OffshoreX/glance_AR_glasses/BOM.md

# Glance (AR Glasses Electronics) – bill of materials

<!-- Generated by Half Life from project cmuw1p55h04n901osjbinddlr. Edits here are overwritten on the next sync. -->
<!-- Generated: 2026-10-11T22:45:20.624Z -->

> [!NOTE]
> This parts list is mirrored from [Half Life](https://halflife.hackclub.com). Editing it here will not change the platform's copy, and the next sync overwrites this file.

| Week | Tier | Parts funding |
| --- | --- | --- |
| Week 1 | Tier 1 | $30.00 |

| Part | What it's for | Qty | Unit | Total | Vendor |
| --- | --- | --- | --- | --- | --- |
| [ESP32-S3-WROOM-1-N16R8 Wi-Fi/BLE module](https://www.lcsc.com/product-detail/C2913202.html) | — | 1 | $5.20 | $5.20 | [LCSC](https://www.lcsc.com/product-detail/C2913202.html) |
| [IR333-A 940nm IR LED 5mm (eye module)](https://www.lcsc.com/product-detail/C264290.html) | — | 1 | $0.06 | $0.06 | [LCSC](https://www.lcsc.com/product-detail/C264290.html) |
| [Bare PCB, 2-layer, 5 pcs (glance-board2)](https://jlcpcb.com) | bare pcbs | 1 | $4.00 | $4.00 | [JLCPCB](https://jlcpcb.com) |
| **Parts subtotal** | — | — | — | **$9.26** | — |
| **Tax & shipping** | — | — | — | **$20.70** | — |
| **Total** | — | — | — | **$29.96** | — |

$0.04 left of the tier's funding.
