OffshoreX/glance_AR_glasses/PCB-stuff/board2/glance-board2.csv

Id | Designator | Footprint | Quantity | Designation | Supplier and ref
1 | C1, C6, C8 | C_0603_1608Metric | 3 | 100nF
2 | C2, C3 | C_0603_1608Metric | 2 | 4.7uF
3 | C4, C7, C9 | C_0603_1608Metric | 3 | 1uF
4 | C5, C10 | C_0603_1608Metric | 2 | 10uF
5 | D1 | LED_0603_1608Metric | 1 | LED
6 | D2 | LED_0603_1608Metric | 1 | Debug LED
7 | J1 | USB_C_Receptacle_HRO_TYPE-C-31-M-12 | 1 | USB_C_Receptacle_USB2.0_16P
8 | J2 | JST_PH_S2B-PH-K_1x02_P2.00mm_Horizontal | 1 | Conn_01x02
9 | J3 | PinHeader_1x04_P2.54mm_Vertical | 1 | OLED
10 | J_EYE_L1, J_EYE_R1, J_IMU1 | PinSocket_1x05_P2.54mm_Vertical | 3 | Conn_01x05
11 | J_LENS1, J_UART1 | PinSocket_1x04_P2.54mm_Vertical | 2 | Conn_01x04
12 | J_TOF1 | PinSocket_1x06_P2.54mm_Vertical | 1 | Conn_01x06
13 | R1, R17, R18 | R_0603_1608Metric | 3 | 330
14 | R2, R3 | R_0603_1608Metric | 2 | 5.1k
15 | R4 | R_0603_1608Metric | 1 | 1k
16 | R5, R6, R7, R12, R13, R14, R15, R16 | R_0603_1608Metric | 8 | 10k
17 | R8, R9 | R_0603_1608Metric | 2 | 100k
18 | R10, R11 | R_0603_1608Metric | 2 | 4.7k
19 | SW1 | SW_SPDT_PCM12 | 1 | SW_SPDT
20 | SW2, SW3, SW4, SW5 | SW_SPST_B3U-1000P | 4 | SW_Push
21 | U1 | TSSOP-10_3x3mm_P0.5mm | 1 | ADS1115IDGS
22 | U2 | SOT-23-5 | 1 | MCP73831-2-OT
23 | U3 | SOT-23-5 | 1 | AP2112K-3.3
24 | U4 | ESP32-S3-WROOM-1 | 1 | ESP32-S3-WROOM-1
