OffshoreX/glance_AR_glasses/JOURNAL.md

# Glance (AR Glasses Electronics) – devlog

<!-- Generated by Half Life from project cmuw1p55h04n901osjbinddlr. Edits here are overwritten on the next sync. -->
<!-- Generated: 2026-10-11T22:58:39.913Z -->

> [!NOTE]
> This devlog is mirrored from [Half Life](https://halflife.hackclub.com). Editing it here will not change the platform's copy, and the next sync overwrites this file.

> Glance is a small controller board for DIY heads-up glasses that display short lines of text in the wearer's line of sight, aimed at reading help and quick information like definitions or notes. A tiny OLED mounted on the frame reflects off a beam splitter angled toward the eye, so the text appears over the real world without blocking it.

| Week | Tier | Hours logged | Entries |
| --- | --- | --- | --- |
| Week 1 | Tier 1 | 18.75h | 9 |

## Contents

1. [2026-10-08 – I started this session by getting started with the most basic components I would need for this project. This included an ESP32, OLED screen, and LED, a resistor, and two push buttons. I did this to pr](#2026-10-08-i-started-this-session-by-getting-started-with-th)
2. [2026-10-08 – ](#2026-10-08-img3094httpshalflifehackclub-assetscomhackclub-ha)
3. [2026-10-09 – Assigned footprints to every part in the schematic, including the USB-C connector, battery connector, switches, resistors, capacitors and the ESP32 module. Then updated the PCB from the schematic and](#2026-10-09-assigned-footprints-to-every-part-in-the-schemati)
4. [2026-10-09 – Video planning and editing for both my idea reel and 5hr progress reel.](#2026-10-09-video-planning-and-editing-for-both-my-idea-reel-)
5. [2026-10-10 – While I was on the plane, I spent an hour rearranging the ratsnest of a PCB design that I'd started with, into a slightly more organized design (for now). I still need to consider a couple parts of my](#2026-10-10-while-i-was-on-the-plane-i-spent-an-hour-rearrang)
6. [2026-10-10 – Late night session:  Routed every connection on the PCB by hand, using both layers and vias where tracks had to cross. Checked that the USB data lines land on the right ESP32 pins before finishing. Th](#2026-10-10-late-night-session-routed-every-connection-on-the)
7. [2026-10-10 – Talked with my dad and changed the project. GLANCE is now glasses for people who see fine at medium distance but need reading glasses up close. The idea is that the glasses figure out how far away you](#2026-10-10-talked-with-my-dad-and-changed-the-project-glance)
8. [2026-10-11 – Doing research on different vendors in terms of parts. To save money within my tier 1 budget, I'm utilizing resistors, header pins, and LEDs that I already have. For the rest, I'll either order them t](#2026-10-11-doing-research-on-different-vendors-in-terms-of-p)
9. [2026-10-11 – Finished the PCB layout for Board 2, the ESP32-S3 sensing platform for the autofocal reading glasses. Placed all parts and hand-routed the USB pair and the main battery-to-3.3V power path. Locked thos](#2026-10-11-finished-the-pcb-layout-for-board-2-the-esp32-s3-)

## Design

### 2026-10-08 – I started this session by getting started with the most basic components I would need for this project. This included an ESP32, OLED screen, and LED, a resistor, and two push buttons. I did this to pr

**1.5h**

I started this session by getting started with the most basic components I would need for this project. This included an ESP32, OLED screen, and LED, a resistor, and two push buttons. I did this to primarily test the wiring logic between the parts. Now that I've confirmed this and that the code works on a Wokwi simulation, I'm going to move on to KiCad, to design the actual PCB for this project. The KiCad design will include the majority of the more complex components, that weren't integrated into the Wokwi sim. Lastly, this step also included setting up the repo, connecting it to Github, and setting up the necessary folders.





### 2026-10-08 – 

**2.5h**





Set up KiCad and drew the schematic for my AR glasses PCB. It covers USB-C power, a battery charger, a 3.3V regulator, the ESP32 chip, an OLED display connector, two buttons and a debug LED.

Problem: I had placed a dev board symbol for the ESP32 (ESP32-C3-DevKitM-1), but my design uses the bare ESP32-C3-MINI-1 module. I installed Espressif’s library in KiCad, swapped in the correct symbol, and rewired it. The ESP32 errors cleared.

Status: Two small ERC errors left to fix (an unannotated resistor and a missing power flag).

AI use: Claude helped with KiCad steps and design review. I drew the schematic myself. No AI-written code.

Next: Fix the ERC errors, then assign footprints so I can turn the schematic into a PCB layout.



### 2026-10-09 – Assigned footprints to every part in the schematic, including the USB-C connector, battery connector, switches, resistors, capacitors and the ESP32 module. Then updated the PCB from the schematic and

**1.75h**

Assigned footprints to every part in the schematic, including the USB-C connector, battery connector, switches, resistors, capacitors and the ESP32 module. Then updated the PCB from the schematic and placed the parts inside a board outline.

I also tried to speed up placement with a script. Claude Code wrote a layout file and a Python script, and I ran the script in KiCad’s scripting console. I fixed path and quote errors along the way and ran it in dry-run mode only. This lowkey didn't work at all, due to an original confusion over why certain elements weren't placed on the board (EdgeCuts layer in KiCad).

Problem: The parts are not organized by their connections yet, so the ratsnest (the thin lines showing which pins connect) is long and tangled. A few capacitors also sit too far from the pins they serve.

AI use: Claude guided the KiCad steps and Claude Code wrote the layout file and script, so that code is AI-written. I did the footprint assignment and board work myself.

Next: Fix the ratsnest by moving each part next to the pins it connects to. Check the schematic for any missing capacitors, then run DRC. This will have to be fully by hand since the script didn't work.







### 2026-10-09 – Video planning and editing for both my idea reel and 5hr progress reel.

**0.75h**

Video planning and editing for both my idea reel and 5hr progress reel.

I’m working on how to blend the catchy social media type video with an informative engineering style video. I had a couple issues with my mic, which is my I had to use an ai generated audio.

I also realized for future videos that I need to incorporate more actual videos instead of pictures, for example filming myself describing the product while holding it.





### 2026-10-10 – While I was on the plane, I spent an hour rearranging the ratsnest of a PCB design that I'd started with, into a slightly more organized design (for now). I still need to consider a couple parts of my

**1h**

While I was on the plane, I spent an hour rearranging the ratsnest of a PCB design that I'd started with, into a slightly more organized design (for now). I still need to consider a couple parts of my project, such as the camera input, plus connection chips to allow some sort of on-device ML processing for text understanding and response. Probably not for the first design iteration, but as I move along, I do need to start really considering size, as the end goal is for this to fit inside a normal pair of sunglasses, so something like an ESP32 obviously wont work.

It could also rely on a mobile connection, so the main processing happens on your phone and you would need to always have it on you, but that's something I'll look into later down the line.

Before organizing: (technically looks organized but it isn't in terms of future wiring)



After organizing:



AI Use: the goal layout that I based this off of was generated by Claude.

### 2026-10-10 – Late night session:  Routed every connection on the PCB by hand, using both layers and vias where tracks had to cross. Checked that the USB data lines land on the right ESP32 pins before finishing. Th

**1.5h**

Late night session:  Routed every connection on the PCB by hand, using both layers and vias where tracks had to cross. Checked that the USB data lines land on the right ESP32 pins before finishing. Then added a ground pour on the bottom layer, kept it out of the antenna area, and ran the design rules check. It shows zero errors, with only silkscreen warnings left.

Next: Clean up the silkscreen, make the ESP32 library part of the project so it opens anywhere, then export the manufacturing files for Half Life. (before this I may revisit original design, and see how it can be improved, as I have time to add elements such as a small camera module)

Before:


Routed and with ground pour:


### 2026-10-10 – Talked with my dad and changed the project. GLANCE is now glasses for people who see fine at medium distance but need reading glasses up close. The idea is that the glasses figure out how far away you

**4h**

Talked with my dad and changed the project. GLANCE is now glasses for people who see fine at medium distance but need reading glasses up close. The idea is that the glasses figure out how far away you’re looking and adjust the lens power to match, instead of you switching between two pairs. (this change is not only due to wanting to solve an issue that my dad has, but also due to the complexity of the AR smart glasses I had orginally planned).

The hard part is knowing what distance you’re focused on, and that’s why the board suddenly has sensors. Two things tell you the distance. The first is a time-of-flight distance sensor facing outward, which measures how far the object in front of you is. The second is eye convergence: when you look at something close, both eyes rotate inward, and the angle between them tells you how far away your focus is. That’s the most accurate at reading distance, which is exactly the range that matters here. To measure each eye’s angle without cameras, I’m using an IR LED and two IR phototransistors per eye. The sclera (white) and the iris reflect IR differently, so the signal changes as the eye moves. Comparing the left and right readings gives the convergence angle. An ADS1115 ADC reads those four analog signals over I2C.

I chose IR sensors over cameras because the ESP32-S3 has only one camera port, so two eye cameras won’t fit, and photodiode sensing is much cheaper and smaller. I also added an IMU, so head tilt can be told apart from eye movement. The board has a header for the future lens driver, but the lens physics isn’t solved yet.

Tonight I swapped the ESP32-C3 for an ESP32-S3, drew the eye sensor circuits, and added headers for the distance sensor, IMU, lens output and serial debug. I also cleaned up my project folders into one GLANCE folder with board1 and board2, so board 1 stays safe. ERC came back with zero errors after I fixed a typo in a net label and a wrong footprint name.

The eye tracking is untested, so whether the sensors are accurate enough is an experiment for week 6. Next: assign footprints, update the PCB, place parts, and route.

Schematic before:


Schematic after:


Folder before:


Folder after:


### 2026-10-11 – Doing research on different vendors in terms of parts. To save money within my tier 1 budget, I'm utilizing resistors, header pins, and LEDs that I already have. For the rest, I'll either order them t

**0.75h**

Doing research on different vendors in terms of parts. To save money within my tier 1 budget, I'm utilizing resistors, header pins, and LEDs that I already have. For the rest, I'll either order them through JLCPCB or LSCS. I'm pretty sure that for the bare PCB, I'll be ordering that through JLCPCB.





### 2026-10-11 – Finished the PCB layout for Board 2, the ESP32-S3 sensing platform for the autofocal reading glasses. Placed all parts and hand-routed the USB pair and the main battery-to-3.3V power path. Locked thos

**5h**

Finished the PCB layout for Board 2, the ESP32-S3 sensing platform for the autofocal reading glasses. Placed all parts and hand-routed the USB pair and the main battery-to-3.3V power path. Locked those tracks, then autorouted the rest with Freerouting, which scored 990/1000 with 31 vias. Set up power net classes and filled GND planes on both layers. Worked the DRC down to zero real errors by fixing track widths, edge clearance and thermal vias, and by cleaning up dangling vias. Built the BOM on LCSC. Replaced the discontinued PT333-3B phototransistor with the PT334-6B. Exported the Gerbers and got a JLCPCB quote for the bare boards. Cut the funded BOM to fit the $30 tier, with the rest self-funded.
