OffshoreX/glance_AR_glasses/pcb_changes.txt

- first PCB design is complete, next step is to
