OffshoreX/glance_AR_glasses/(list of files, drawings)

Other design files:
PCB-stuff/board2/glance-board2.dsn
