OffshoreX/glance_AR_glasses/PCB-stuff/board2/glance-board2.kicad_pcb

## KiCad design PCB-stuff/board2/glance-board2.kicad_pcb (2026-10-12)

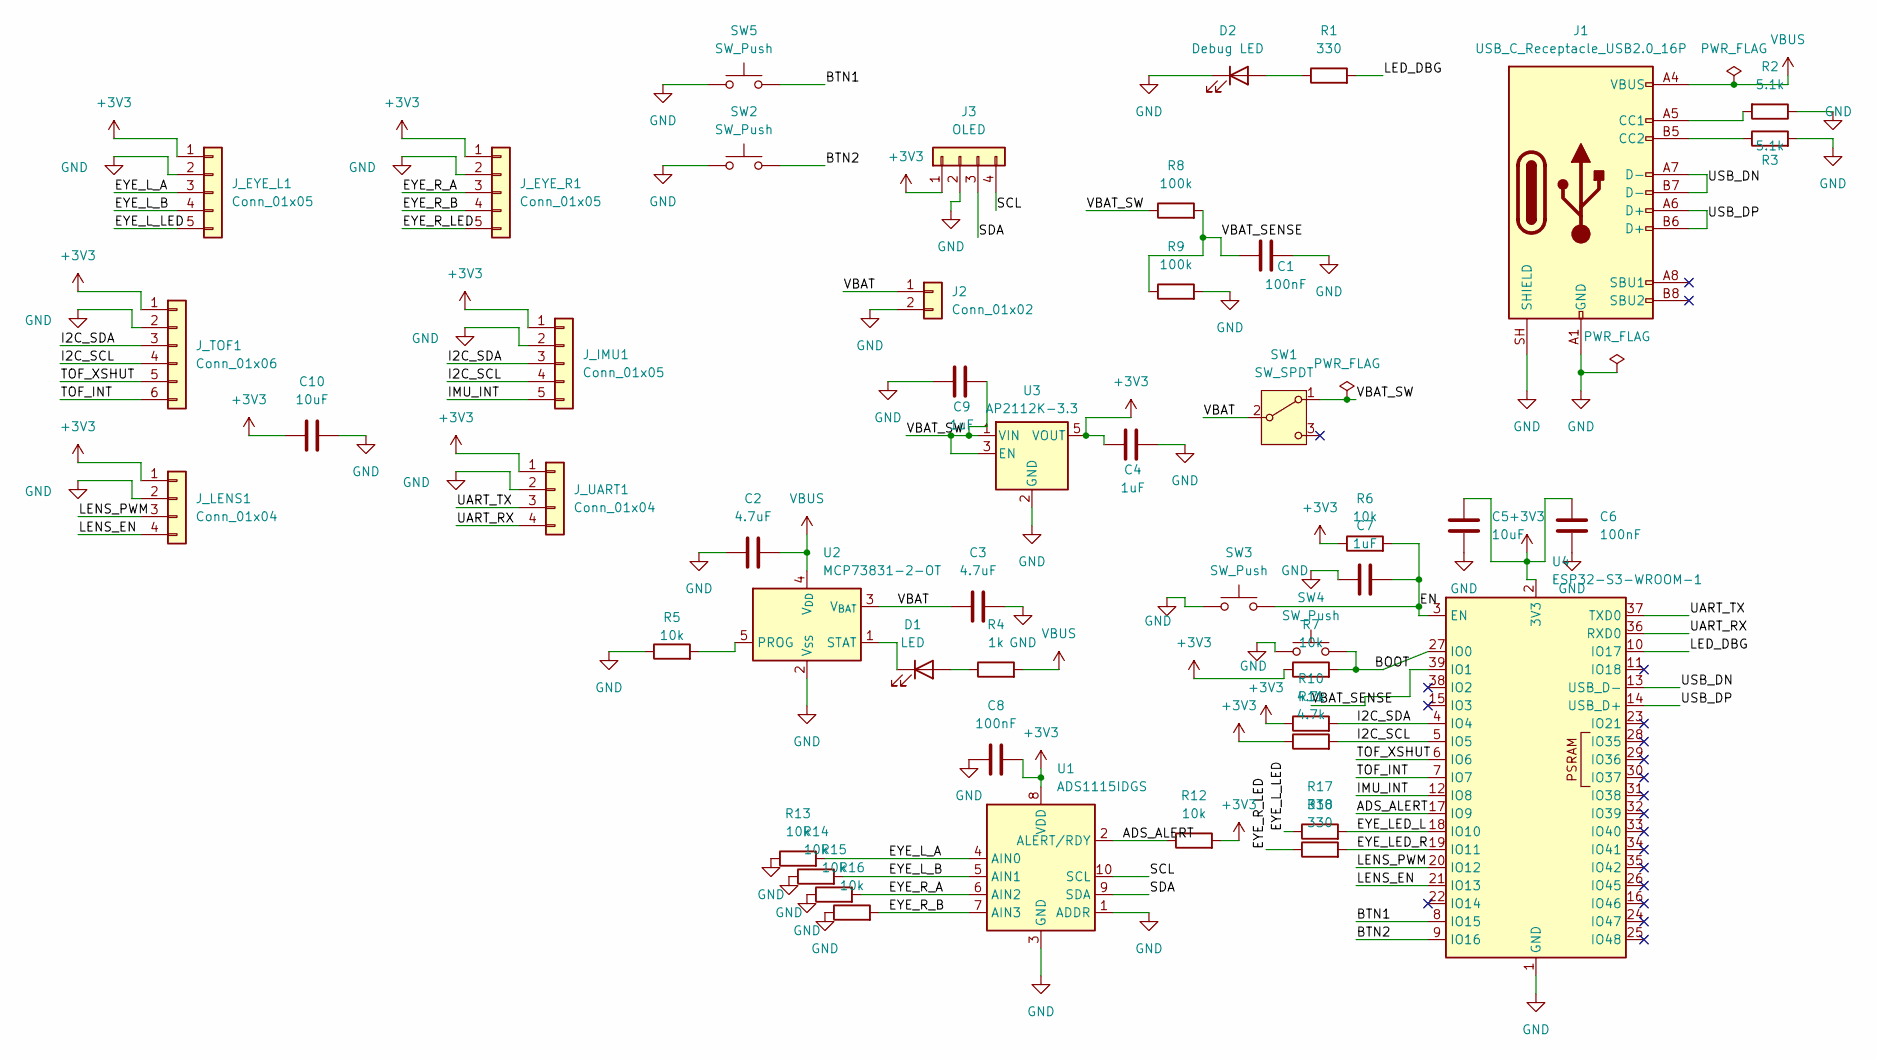
[picture p1: schematic glance-board2.kicad_sch, Glance PCB Schematic]

Parts:
C1, C6, C8: 100nF; C_0603_1608Metric
C2, C3: 4.7uF; C_0603_1608Metric
C4, C7, C9: 1uF; C_0603_1608Metric
C5, C10: 10uF; C_0603_1608Metric
D1: LED; LED_0603_1608Metric
D2: Debug LED; LED_0603_1608Metric
J1: USB_C_Receptacle_USB2.0_16P; USB_C_Receptacle_HRO_TYPE-C-31-M-12
J2: Conn_01x02; JST_PH_S2B-PH-K_1x02_P2.00mm_Horizontal
J3: OLED; PinHeader_1x04_P2.54mm_Vertical
J_EYE_L1: Conn_01x05; PinSocket_1x05_P2.54mm_Vertical
J_EYE_R1: Conn_01x05; PinSocket_1x05_P2.54mm_Vertical
J_IMU1: Conn_01x05; PinSocket_1x05_P2.54mm_Vertical
J_LENS1: Conn_01x04; PinSocket_1x04_P2.54mm_Vertical
J_TOF1: Conn_01x06; PinSocket_1x06_P2.54mm_Vertical
J_UART1: Conn_01x04; PinSocket_1x04_P2.54mm_Vertical
R1, R17, R18: 330; R_0603_1608Metric
R2, R3: 5.1k; R_0603_1608Metric
R4: 1k; R_0603_1608Metric
R5, R6, R7, R12, R13, R14, R15, R16: 10k; R_0603_1608Metric
R8, R9: 100k; R_0603_1608Metric
R10, R11: 4.7k; R_0603_1608Metric
SW1: SW_SPDT; SW_SPDT_PCM12
SW2, SW3, SW4, SW5: SW_Push; SW_SPST_B3U-1000P
U1: ADS1115IDGS; TSSOP-10_3x3mm_P0.5mm
U2: MCP73831-2-OT; SOT-23-5
U3: AP2112K-3.3; SOT-23-5
U4: ESP32-S3-WROOM-1

Connections:
+3V3: C4.1, C5.1, C6.1, C8.2, C10.1, J3.1, J_EYE_L1.1, J_EYE_R1.1, J_IMU1.1, J_LENS1.1, J_TOF1.1, J_UART1.1, R6.1, R7.1, R10.1, R11.1, R12.2, U1.8 (VDD), U3.5 (VOUT), U4.2 (3V3)
/ADS_ALERT: R12.1, U1.2 (ALERT/RDY), U4.17 (IO9)
/BOOT: R7.2, SW4.2, U4.27 (IO0)
/BTN1: SW5.2, U4.8 (IO15)
/BTN2: SW2.2, U4.9 (IO16)
/EN: C7.2, R6.2, SW3.2, U4.3 (EN)
/EYE_LED_L: R17.2, U4.18 (IO10)
/EYE_LED_R: R18.2, U4.19 (IO11)
/EYE_L_A: J_EYE_L1.3, R13.2, U1.4 (AIN0)
/EYE_L_B: J_EYE_L1.4, R14.2, U1.5 (AIN1)
/EYE_L_LED: J_EYE_L1.5, R17.1
/EYE_R_A: J_EYE_R1.3, R15.2, U1.6 (AIN2)
/EYE_R_B: J_EYE_R1.4, R16.2, U1.7 (AIN3)
/EYE_R_LED: J_EYE_R1.5, R18.1
/I2C_SCL: J_IMU1.4, J_TOF1.4, R11.2, U4.5 (IO5)
/I2C_SDA: J_IMU1.3, J_TOF1.3, R10.2, U4.4 (IO4)
/IMU_INT: J_IMU1.5, U4.12 (IO8)
/LED_DBG: R1.2, U4.10 (IO17)
/LENS_EN: J_LENS1.4, U4.21 (IO13)
/LENS_PWM: J_LENS1.3, U4.20 (IO12)
/SCL: J3.4, U1.10 (SCL)
/SDA: J3.3, U1.9 (SDA)
/TOF_INT: J_TOF1.6, U4.7 (IO7)
/TOF_XSHUT: J_TOF1.5, U4.6 (IO6)
/UART_RX: J_UART1.4, U4.36 (RXD0)
/UART_TX: J_UART1.3, U4.37 (TXD0)
/USB_DN: J1.A7 (D-), J1.B7 (D-), U4.13 (USB_D-)
/USB_DP: J1.A6 (D+), J1.B6 (D+), U4.14 (USB_D+)
/VBAT: C3.1, J2.1, SW1.2 (B), U2.3 (V_{BAT})
/VBAT_SENSE: C1.2, R8.2, R9.1, U4.39 (IO1)
/VBAT_SW: C9.2, R8.1, SW1.1 (A), U3.1 (VIN), U3.3 (EN)
GND: C1.1, C2.1, C3.2, C4.2, C5.2, C6.2, C7.1, C8.1, C9.1, C10.2, D2.1 (K), J1.A1 (GND), J1.A12 (GND), J1.B1 (GND), J1.B12 (GND), J1.SH (SHIELD), J2.2, J3.2, J_EYE_L1.2, J_EYE_R1.2, J_IMU1.2, J_LENS1.2, J_TOF1.2, J_UART1.2, R2.1, R3.2, R5.1, R9.2, R13.1, R14.1, R15.1, R16.1, SW2.1, SW3.1, SW4.1, SW5.1, U1.1 (ADDR), U1.3 (GND), U2.2 (V_{SS}), U3.2 (GND), U4.1 (GND), U4.40 (GND), U4.41 (GND)
unnamed: D1.2 (A), R4.1
unnamed: D1.1 (K), U2.1 (STAT)
unnamed: D2.2 (A), R1.1
unnamed: J1.A5 (CC1), R2.2
unnamed: J1.B5 (CC2), R3.1
unnamed: R5.2, U2.5 (PROG)
VBUS: C2.2, J1.A4 (VBUS), J1.A9 (VBUS), J1.B4 (VBUS), J1.B9 (VBUS), R4.2, U2.4 (V_{DD})

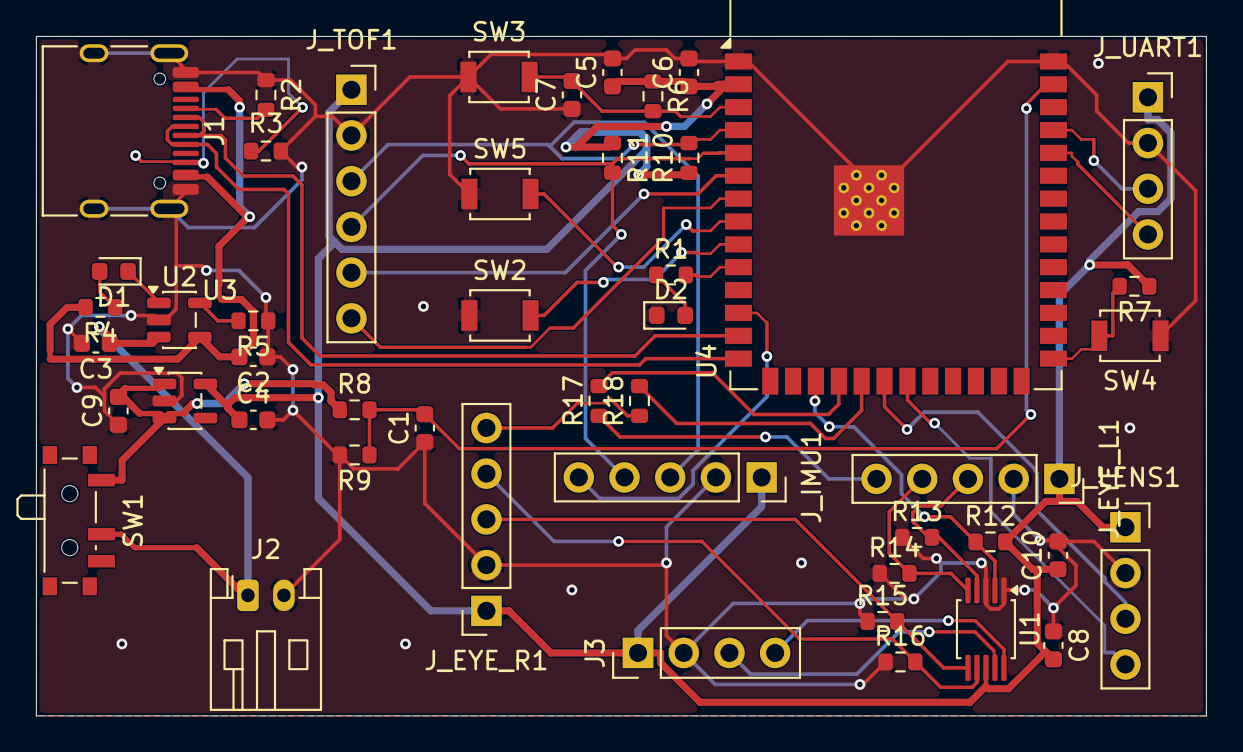
[picture p2: board PCB-stuff/board2/glance-board2.kicad_pcb from above]

Board: 2 copper layers, 65.0 x 37.8 mm, 48 parts (0 on the bottom side), 39 nets.
