OffshoreX/glance_AR_glasses/PCB-stuff/board1/_old/glance-board2.kicad_pcb

## KiCad design PCB-stuff/board1/_old/glance-board2.kicad_pcb (2026-10-12, an earlier design)

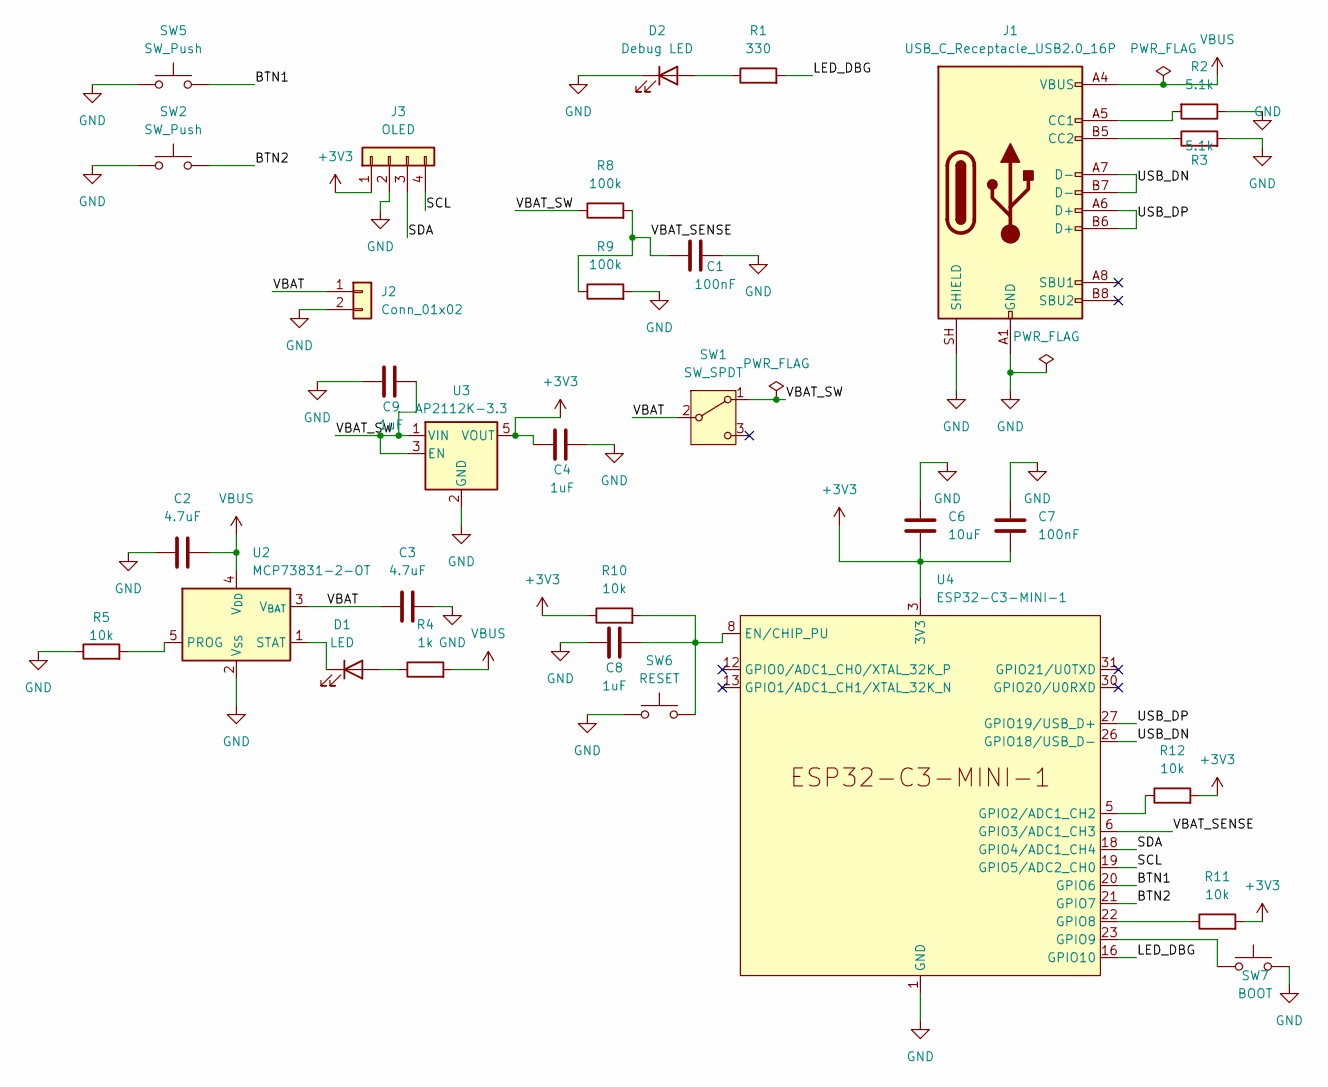
[picture p3: schematic glance-board2.kicad_sch, Glance PCB Schematic]

Parts:
C1, C7: 100nF; C_0603_1608Metric
C2, C3: 4.7uF; C_0603_1608Metric
C4, C8, C9: 1uF; C_0603_1608Metric
C6: 10uF; C_0603_1608Metric
D1: LED; LED_0603_1608Metric
D2: Debug LED; LED_0603_1608Metric
J1: USB_C_Receptacle_USB2.0_16P; USB_C_Receptacle_HRO_TYPE-C-31-M-12
J2: Conn_01x02; JST_PH_S2B-PH-K_1x02_P2.00mm_Horizontal
J3: OLED; PinHeader_1x04_P2.54mm_Vertical
R1: 330; R_0603_1608Metric
R2, R3: 5.1k; R_0603_1608Metric
R4: 1k; R_0603_1608Metric
R5, R10, R11, R12: 10k; R_0603_1608Metric
R8, R9: 100k; R_0603_1608Metric
SW1: SW_SPDT; SW_SPDT_PCM12
SW2, SW5: SW_Push; SW_SPST_B3U-1000P
SW6: RESET; SW_SPST_B3U-1000P
SW7: BOOT; SW_SPST_B3U-1000P
U2: MCP73831-2-OT; SOT-23-5
U3: AP2112K-3.3; SOT-23-5
U4: ESP32-C3-MINI-1

Connections:
+3V3: C4.1, C6.2, C7.2, J3.1, R10.1, R11.2, R12.2, U3.5 (VOUT), U4.3 (3V3)
/BTN1: SW5.2, U4.20 (GPIO6)
/BTN2: SW2.2, U4.21 (GPIO7)
/LED_DBG: R1.2, U4.16 (GPIO10)
/SCL: J3.4, U4.19 (GPIO5/ADC2_CH0)
/SDA: J3.3, U4.18 (GPIO4/ADC1_CH4)
/USB_DN: J1.A7 (D-), J1.B7 (D-), U4.26 (GPIO18/USB_D-)
/USB_DP: J1.A6 (D+), J1.B6 (D+), U4.27 (GPIO19/USB_D+)
/VBAT: C3.1, J2.1, SW1.2 (B), U2.3 (V_{BAT})
/VBAT_SENSE: C1.2, R8.2, R9.1, U4.6 (GPIO3/ADC1_CH3)
/VBAT_SW: C9.2, R8.1, SW1.1 (A), U3.1 (VIN), U3.3 (EN)
GND: C1.1, C2.1, C3.2, C4.2, C6.1, C7.1, C8.1, C9.1, D2.1 (K), J1.A1 (GND), J1.A12 (GND), J1.B1 (GND), J1.B12 (GND), J1.SH (SHIELD), J2.2, J3.2, R2.1, R3.2, R5.1, R9.2, SW2.1, SW5.1, SW6.1, SW7.2, U2.2 (V_{SS}), U3.2 (GND), U4.1 (GND), U4.2 (GND), U4.11 (GND), U4.14 (GND), U4.36 (GND), U4.37 (GND), U4.38 (GND), U4.39 (GND), U4.40 (GND), U4.41 (GND), U4.42 (GND), U4.43 (GND), U4.44 (GND), U4.45 (GND), U4.46 (GND), U4.47 (GND), U4.48 (GND), U4.49 (GND), U4.50 (GND), U4.51 (GND), U4.52 (GND), U4.53 (GND)
unnamed: D1.2 (A), R4.1
unnamed: D1.1 (K), U2.1 (STAT)
unnamed: D2.2 (A), R1.1
unnamed: J1.A5 (CC1), R2.2
unnamed: J1.B5 (CC2), R3.1
unnamed: R5.2, U2.5 (PROG)
unnamed: C8.2, R10.2, SW6.2, U4.8 (EN/CHIP_PU)
unnamed: R12.1, U4.5 (GPIO2/ADC1_CH2)
unnamed: R11.1, U4.22 (GPIO8)
unnamed: SW7.1, U4.23 (GPIO9)
VBUS: C2.2, J1.A4 (VBUS), J1.A9 (VBUS), J1.B4 (VBUS), J1.B9 (VBUS), R4.2, U2.4 (V_{DD})

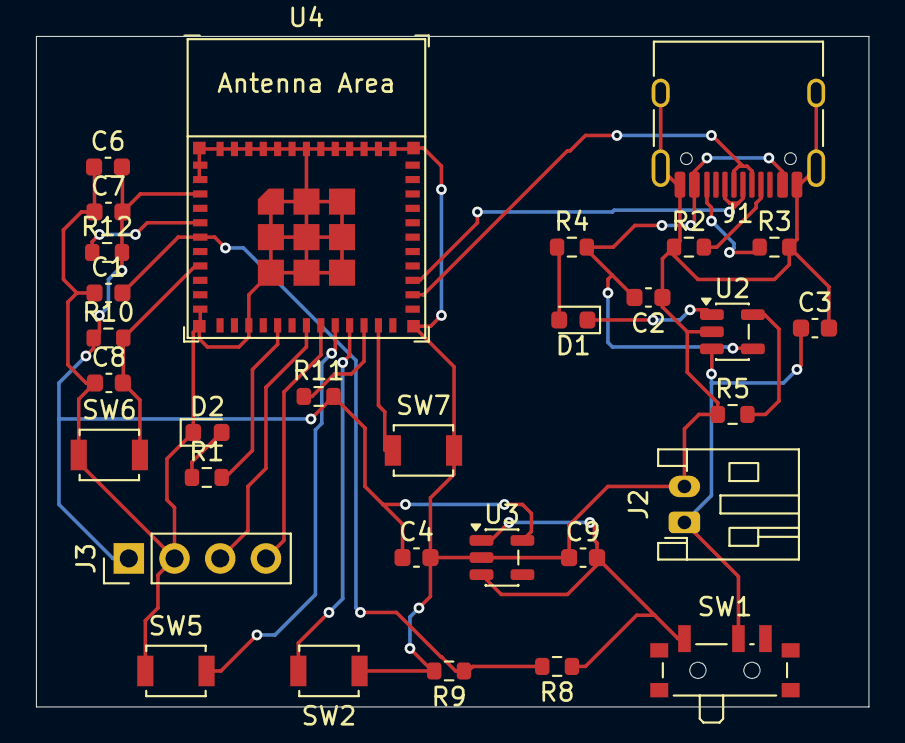
[picture p4: board PCB-stuff/board1/_old/glance-board2.kicad_pcb from above]

Board: 2 copper layers, 46.2 x 37.2 mm, 31 parts (0 on the bottom side), 23 nets.
