OffshoreX/glance_AR_glasses/(commit log)

2026-10-08 Scaffold Glance repo: firmware skeleton, companion stub, old prototype archived
2026-10-09 Add GLANCE KiCad project and generated layout.yaml
    [glance-pcb.kicad_pcb, glance-pcb.kicad_sch]
2026-10-09 Add board bring-up firmware, Wokwi sim, apply_layout.py, updated layout.yaml
2026-10-09 apply_layout.py: read layout.json, run in KiCad console; add layout.json
2026-10-09 Update file paths for PCB layout application
2026-10-11 Add GLANCE PCB BOM csv
2026-10-11 Update notes, companion, wokwi sim; add pcb_changes
2026-10-12 Move PCB into board1/board2, add board2 manufacturing files
